Keerthibaalan/XY-Pen-Plotter/User, Technical and Design/Team23-PenPlotter_v5.xlsx

Sheet: User,Technical & Design Requri
Project Name |  | XY-Pen Plotter
Date |  | 2023-12-03
Version |  | 5-Final Version
Group Name |  | MERO Team 23
Group Members |  | Daniya Ahmed Mohamad Sahil Nazeer Keerthibaalan Thiruvalluvan Ram Charan Vuyyala Rathan Pradeep Kumar
UR # | Title | User Requirement | Remark | Domain (HW/SW/ME/all) | Must / Wish | TS # | ref. to UR # | Title | Technical Requirement | Remark | Domain (HW/SW/ME/all) | Must / Wish | DS # | ref. to TS # | Description | Reference (# bill of materials, article # supplier part, ref. doc # etc..) to implementation | Remark | Domain (HW, SW, ME, all)
Application |  |  |  |  |  | Application |  |  |  |  |  |  | Application
UR1 | Intended Use | The 2D pen plotter should be designed with the capability of creating a Nicolas House using a microcontroller. |  | all | Must | TS1 | UR1 UR2 | Intended Use | The 2D pen-plotter is speciafially designed for educational purpose, to be used by the MERO students, to draw a Nicolas house and understand the working of a Mechatronics system |  | all | Must | DS1 | TS1 TS2 TS3 TS4 | The 2D pen-plotter is aimed at education purpose; to be used only within the university, both by professors and students | Group23_PenPLotter_Project_Dossier |  | all
UR2 |  | It is intended to be used only for academic purpose by the University students to understand the synergy between different domains of a Mechatronic system. |  | all | Must | TS2 | UR3 UR4 | Focus Group | The plotter is designed with the intention to be used by both MERO students and faculties of all genders and of the age group 20-60 years |  | all | Must
UR3 | Focus Group | The main focus group for the device are the Master's students of Mechatronics and Robotics. |  | all | Must | TS3 | UR5 | Use case | The pen plotter is mainly developed to satisfy the purpose of drawing a Nicolas house, by controlling the motion of a pen in the X and Y directions |  | all | Must
UR4 |  | Anyone (male/female/others) between the age of 20 and 60 years should also be able to use it. |  | all | Must | TS4 | UR6 | Site of Application | The unit is developed with the intention of using it indoors, especially in a laboratory setting. It could also be used in homes, offices and other indoor environments |  | all | Must
UR5 | Use case | Drawing the Nicolas House in a linear motion by moving the pen plotter in the X and Y directions. |  | all | Must
UR6 | Site of Application | The plotter is mainly designed for indoor use, including but not limited to laboratory work inside university, homes and offices. |  | all | Must
General Functions |  |  |  |  |  | General Functions |  |  |  |  |  |  | General Functions
UR7 | Portability | It should be compact and light so that it can be easily managed and carried around. |  | all | Must | TS5 | UR7 | Dimensions | The whole plotter assembly should be able to fit in a box of dimension 56x39x42cm |  | all | Must | DS2 | TS5 | Overall dimension should be less than 305x305x420 mm | Base Plate; Bill of materials (doc.#(Group23_BOM)) |  | all
UR8 | Lifespan | The unit should work flawless at least for one semester. |  | all | Must | TS6 |  | Weight | The weight of the entire unit, including the frame and components should not exceed 3.5 kg |  | all | Must | DS3 |  |  | CAD Assembly Model (PenPlotter.sldasm) |  | all
UR9 | Precision | The plotter should be able to draw perfect straight lines with high accuracy and precision. |  | ME | Must | TS7 | UR8 | Lifespan | Th pen plotter should operate for atleast 100 cycles of Nicolas House or 60-70m of pen motion |  | all | Must | DS4 | TS6 | Overall weight of the unit should be less than 3.5kg | Bill of materials (doc.#(Group23_BOM)) |  | all
UR10 | Speed | It should be able to draw quickly and in a time efficient manner. |  | HW | Wish | TS8 | UR9 UR12 | Precision & Consistency | The lines drawn should be perfectly straight with an accuracy of 0.1mm and the offset between the lines should be less than 1mm |  | all | Must | DS5 |  |  | CAD Assembly Model (PenPlotter.sldasm) |  | all
UR11 | Durability | The build should be sturdy enough to withstand minor drops and shocks. |  | ME | Must | TS9 | UR10 | Speed | The Nicolas house should be drawn within 45 seconds (approximately 5 seconds per line) |  | HW | Wish | DS6 | TS7 | Total Life span should be either 100 cycles of the drawing or 60-70 m of pen motion | Bill of materials (doc.#(Group23_BOM)) |  | all
UR12 | Consistency | It should create the drawings consistently without any offsets in the lines drawn. |  | all | Must | TS10 | UR11 | Durability | The box holding the unit should be lined with shock absorber material, so that it can withstand mishandlings and drops from a height of 0.5m |  | ME | Must | DS7 | TS8 TS11 TS12 | Precise lines to be drawn without any offsets | Guide shafts, Timing Belt, Dampers; Bill of materials (doc.#(Group23_BOM)) |  | all
UR13 | Stability | The unit should create the drawing without much vibration. |  | ME | Must | TS11 | UR13 UR14 | Stability & Quiet Operation | The belts used for transmitting power should be elastic and able to restrict the lateral vibration |  | ME | Must | DS8 | TS9 TS28 | Total time taken for drawing should be less than a minute | Motors, Motor Drivers; Bill of materials (doc.#(Group23_BOM)) |  | HW
UR14 | Quiet operation | It should operate quietly without generating excessive noise. |  | ME | Wish | TS12 |  |  | Dampers are installed between the motor and the base plate, that absorbs vibrartions inturn leading to reduced noise. |  | ME | Must | DS9 | TS10 | Minor shocks due to mishandling or drops should be withstood | Shock absorber; Bill of materials (doc.#(Group23_BOM)) | Cost effective materials like 'Bubble wraps' could be used | ME
UR15 | Usability | It should be easy to setup and use, without the need for any special tools or skills. |  | all | Must | TS13 | UR15 UR16 | Ease of usage and maintenance | The plotter follows a modular design that enables easy assembly and disassembly of the components; this also makes the maintenance easy |  | HW & ME | Must | DS10 | TS13 | Modular design of the unit for easy assembly and maintenance | CAD Assembly Model (PenPlotter.sldasm) |  | ME & HW
UR16 | Maintenance | The assembly, disassembly and cleaning of the unit should be easy to do. |  | all | Must | TS14 | UR17 | Safety | The maximum volatge supply used should be less than 24V, so that no strict supervision of the users is needed |  | HW | Must | DS11 | TS14 | The supply voltage should not be greater than 24V | Power Supply Unit; Bill of materials (doc.#(Group23_BOM)), Technical datasheet. | Breadboard Power supply TS1171 is used | HW
UR17 | Safety | The plotter should be safe to use by anyone from the Focus group without any strict supervision. |  | all | Must | TS15 |  |  | The motors and the other electronic components should be covered with proper insulating materials |  | HW | Must | DS12 | TS15 TS34 | Proper insulation should be provided for the electrical and electronic components | PVC Pipes; Bill of materials (doc.#(Group23_BOM)) |  | HW
UR18 | Safety | There should be some safety provisions available to stop the plotter in case of an emergency. |  | HW & SW | Must | TS16 | UR18 | Safety | There should be a dedicated stop switch to stop the operation in case of emergency |  | HW | Wish | DS13 | TS16 | Provision for Emergency stop button | Red Push Button; Bill of materials (doc.#(Group23_BOM)) |  | HW
UR19 | Calibration | There should be a dedicated point on the plot area which is used for calibration. |  | ME | Must | TS17 | UR19 | Calibration | An explicit reference point should be defined to carry out the calibration process |  | SW | Must | DS14 |  |  | Microncontroller Program (PenPlotter_MainProgram.c) |  | SW
Module Function |  | Tool Gripper |  |  |  | Module Function |  |  | Tool Gripper |  |  |  | DS15 | TS17 | Explicit reference point for Calibration | Microncontroller Program (PenPlotter_MainProgram.c) |  | SW
UR20 | Size | The gripper should be compatible with different types and sizes of writing tools like pen, pencil, marker etc. |  | HW | Must | TS18 | UR20 | Pen Size | The gripper should be able to hold writing tools like pens, pencils etc. with maximum outer diameter of 15mm |  | HW | Must | Module Function |  | Tool Gripper
UR21 | Grip | It should be tight enough to hold the pen in the exact position throughout the trial. |  | HW | Must | TS19 | UR21 | Grip | The gripper should have provisions like loaded spring or screws that holds the writing tool firmly in a defined position and the pressure is evenly distributed |  | HW | Must | DS16 | TS18 | The gripper is designed for holding writing tools of various sizes | CAD Model (Gripper.sld) |  | HW & ME
UR22 | Easy installation | It should be easy to insert and remove writing the tools from the gripper |  | HW | Must | TS20 | UR22 | Easy installation | The gripper part should be 3D printed and detachable from the slider base, so that the writing tool can be easily fixed or removed. |  | HW | Must | DS17 | TS19 TS20 TS21 | The gripper assembly should hold the tool firmly and should be easy to maintain | CAD Assembly Model (ToolGripper.sldasm) |  | HW & ME
Module Function |  | Plotting Board + Frame |  |  |  | TS21 | UR30 | Flexibility | There should be enogh provision on the tool holder to put the tool gripper at any angle |  | ME | Must | Module Function |  | Plotting Board + Frame
UR23 | Size | The plotting board should have enough space to accommodate the pen-plotter and the paper. |  | HW & ME | Must | Module Function |  |  | Plotting Board + Fame |  |  |  | DS18 | TS22 TS23 TS24 | The Plotting Board should hold papers of different sizes and its surface should be properly polished | Wooden Baseplate; Bill of materials (doc.#(Group23_BOM)) |  | HW
UR24 | Paper | Should be able to accommodate different standard sizes and thickness of paper. |  | HW | Must | TS22 | UR23 | Size | The maximum size of the plotting board should not exceed the dimension 56x42cm, so that it can fit in the box |  | HW & ME | Must | DS19 | TS25 | The board is provided with clamps to hold the paper in place | Clamps/Clips; Bill of materials (doc.#(Group23_BOM)) |  | HW
UR25 | Surface | The plotting surface must be smooth enough to get legible drawings. |  | HW | Must | TS23 | UR24 | Paper | Paper of any size between 10x10cm and A4 size should be able to be accommodated |  | HW | Must | DS20 | TS26 | Mounts for necessary equipments should be 3D printed separately | CAD Model (Mounts.sld) | Separate CAD models for all the mounts needed. | ME
UR26 | Clamping | There should be provisions given for proper clamping of the paper. |  | HW & ME | Must | TS24 | UR25 | Surface & Thickness | Properly polished wooden board has to be used as the base plateand its thickness has to be selected in such a way that the total weight falls under the specified amount |  | HW | Must | DS21 | TS27 | Robber bushes on the bottom of the baseplate to prevent slipping | Rubber Bushes; Bill of materials (doc.#(Group23_BOM)) |  | HW
UR27 | Mounts | There should be separate mounts for the hardware components utilized. |  | ME | Must | TS25 | UR26 | Clamping | The board has to be included with mounting easel (board with clips) that can hold paper, cards and envelopes of various sizes |  | HW & ME | Must
UR28 | Anti-slip | Provisions should be available to prevent the base plate from slipping |  | ME | Wish | TS26 | UR27 | Mounts | The board should have provisions to hold the 3D printed mounts created for the individual components. |  | ME | Must
Module Function |  | Drive System |  |  |  | TS27 | UR28 | Anti-slip | The bottom side of the Plotting board should have rubber bushes to prevent it from slipping |  | ME | Wish
UR29 | Speed | It should be possible to move the gripper with various velocities. |  | ME | Must | Module Function |  |  | Drive System |  |  |  | Module Function |  | Drive System
UR30 | Flexibility | Drawing lines at any angle should be possible on the 2D plane. |  | ME | Must | TS28 | UR29 UR39 | Speed | The motors used should be controlled by appropriate motor drivers that is capable of operating the motors in variable speeds based on the program written. |  | ME | Must | DS22 | TS29 | Power from the motor should be transferred efficiently | Timing Belt; Bill of materials (doc.#(Group23_BOM)) |  | HW
UR31 | Efficiency | The power from the actuators (motors) should be transferred efficiently to the gripper without much loss. |  | ME & HW | Must | TS29 | UR31 | Efficiency | Need to use timing belts/ropes and pulley drives for efficient transfer of the motion or power from the motors to the slider. i.e., without any slippage |  | ME & HW | Must
UR32 | Feedback | It should be an open-loop drive system which does not require any feedback. |  | ME | Must | TS30 | UR32 | Feedback | The system should be simple, that is there is no need to use any sensors to obtain the feedback from the tool gripper |  | ME | Must
Module Function |  | Power Supply |  |  |  | Module Function |  |  | Power Supply |  |  |  | Module Function |  | Power Supply
UR33 | Power | The plotter unit should be powered via a USB port |  | HW | Must | TS31 | UR33 | Power | The supply voltage should range between 3.3 and 3.6V, and a minimum current of 500mA, supplied via a USB Type cable |  | HW | Must | DS23 | TS31 TS33 | The required power supply (500mA @ 3.3 - 3.6 V) should be supplied via a USB Type cable | Lithium Battery, Power Supply unit; Bill of materials (doc.#(Group23_BOM)), Technical datasheet | Breadboard Power supply TS1171 is used | HW
UR34 | Button | Push button should be used to turn on/off the unit. |  | HW | Must | TS32 | UR34 | Power button | Dedicated push button should be provided to turn the pen plotter on/off |  | HW | Must | DS24 | TS32 | A push button to turn the pen plotter on/off is provided | Green Push Button; Bill of materials (doc.#(Group23_BOM)) |  | HW
UR35 | Safety | Safety measures against current overloading and voltage fluctuations should be provided |  | HW | Must | TS33 | UR35 | Safety | The power supply is chosen such that any marginal overcurrent or voltage cannot damage the electronic components |  | HW | Must
Module Function |  | Connections |  |  |  | Module Function |  |  | Connections |  |  |  | Module Function |  | Connections
UR36 | Cables | Standard cables should be used to establish connections without any soldering. |  | HW | Must | TS34 | UR36 UR37 | Cables | CE certified Jumper cables should be used to establish the circuit connection. These cables should be standard, properly insulated and avoid the need for soldering. Cable guides should be used for cable routing |  | HW | Must | DS25 | TS34 | Standard cables should be used for power and data transfer | Jumper cables; Bill of materials (doc.#(Group23_BOM)) |  | HW
UR37 | Insulation | The wires should be properly insulated to avoid any hazards. |  | HW | Must
Module Function |  | Control Unit |  |  |  | Module Function |  |  | Control Unit |  |  |  | Module Function |  | Control Unit
UR38 | Microcontroller | Standard microcontroller should be used to control the overall working of the plotter. |  | HW | Must | TS35 | UR38 | Microcontroller | A Standard microcontroller should be used to control the entire unit. |  | HW | Must | DS26 | TS35 TS37 | Standard Microcontroller should be used and all the electronic components should have a common ground | ESP32 Microcontroller, Jumper cables; Bill of materials (doc.#(Group23_BOM)) |  | HW
UR39 | Drivers | There should be drivers to control the actuators and ensure their smooth functioning. |  | HW | Must | TS36 | UR40 | Sensors/switches | Limit switches or Position sensors need to be used to determine the end positions |  | HW | Must | DS27 | TS36 | The end positions of the gripper should identified using Limit switches / sensors | Hall effect sensor, Limit Switches; Bill of materials (doc.#(Group23_BOM)) |  | HW
UR40 | Sensors/Switches | The plotter should be able to detect home and end positions. |  | HW | Must | TS37 | UR41 | Grounding | The electronic components used should be properly grounded to the microcontroller ground to eliminate noises |  | HW | Must
UR41 | Grounding | All Electronics should be properly grounded to avoid unnecessary noises. |  | HW | Must
Module Function |  | Software |  |  |  | Module Function |  |  | Software |  |  |  | Module Function |  | Software
UR42 | HMI | An interface should be available to control the plotter via smartphone using Bluetooth or Wi-Fi. |  | SW | Must | TS38 | UR42 | HMI | A Human Machine Interface needs to be developed that provides a communication between a smartphone and the controller of the plotter via Wi-Fi. |  | SW | Must | DS28 | TS38 TS41 TS42 TS43 | A C program should be written that is capable of carrying out all the required pen plotter tasks | Microncontroller Program (PenPlotter_MainProgram.c) | Separate functions corresponding to the individual tasks should be created | SW
UR43 | Workstation | The program/data file should be feeded via any device compatible with the microcontroller |  | SW | Must | TS39 | UR43 | Workstation | Any laptop either with windows or mac OS with an internet access and an USB port, should be able to code the microcontroller used. |  | SW | Must | DS29 | TS40 | An Integrated Development Environment for developing C programs and loading them into the microcontroller has to be used | Reference to the Arduino IDE |  | SW
UR44 | IDE | An open source IDE should be used to write, execute and load the codes into the microcontroller. |  | SW | Must | TS40 | UR44 | IDE | The Arduino IDE should be used to write and load the code into the ESP32 microcontroller. C language should be used for programming |  | SW | Must
UR45 | Code structure | The code should be easily readable and understandable. |  | SW | Must | TS41 | UR45 | Code structure | While writing the code, standard headers files should be used, proper naming conventions for variables have to be followed, necessary comments should be added and appropriate indentations should be used. |  | SW | Must
UR46 | Messages | The user interface should show appropriate messages based on the current action or error. |  | SW | Wish | TS42 | UR46 | Messages | The program should include functions to display appropriate messages like 'Drawing in Progress', 'Error Occured', 'Process Completed' |  | SW | Wish
UR47 | Customization | The unit should be capable of creating drawings other than Nikolaus House. |  | SW | Wish | TS43 | UR47 | Customization | A logic capable of converting any desired drawings into corresponding codes should be integrated as part of the main program |  | SW | Wish
Commercial Requirements |  |  |  |  |  | Commercial Requirement |  |  |  |  |  |  | Commercial Requirement
UR48 | Date of Completion | The plotter should be completely built and be ready for the presentation before the date of exam |  | all | Must | TS44 | UR48 | Date of Completion | The plotter along with the entire Hardware and software components should be completed and be ready for submission before November 2023 |  | all | Must | DS30 | TS45 | The Total cost incurred for developing the Pen Plotter should not exceed 100 Euros | Bill of materials (doc.#(Group23_BOM)) |  | all
UR49 | Cost | The plotter should be economical and the total cost of the unit should not exceed 100 Euros |  | all | Wish | TS45 | UR49 | Cost | The majority of the components used shall be 3D printed using ABS (Acrylonitrile Butadiene Styrene) to keep the cost down |  | all | Wish | DS31 |  |  | CAD Assembly Model (PenPlotter.sldasm) |  | all
Regulations and Standards |  |  |  |  |  | Regulations and Standards |  |  |  |  |  |  | Regulations and Standards
UR50 | Conformity to standards | The parts and components used should be compliant with the corresponding standards. |  | all | Must | TS46 | UR50 UR51 | Conformity to Standards | All the hardware components used should follow the DIN/ISO standards and the electrical/electronic components should follow the IEC/IEEE and RoHS standards |  | all | Must | DS32 | TS46 TS47 | The supplier parts and designed model should follow conformity to their corresponding standards | Reference to documents related to standards like DIN, ISO, IEC and so on |  | all
UR51 | Quality Standards | The plotter should adhere to industrial quality standards | Since it is only for academic purpose, no need to follow the DKE standardization policies | all | Must | TS47 | UR51 | Quality Standard | The parts 3D printed in the University Laboratory must be standardized and fit into requirements |  | all | Must

Sheet: Verification and Validation
Verification Protocol |  |  |  |  | Verification Report |  |  |  |  |  |  | Validation Protocol |  |  |  |  |  |  |  | Validation Report
VerP # | ref to TS # | test procedure (description of routine) | verification criterion | Domain (HW/SW/ME/all) | VerR # | ref. to VerP # | Test function (to be copied from verification protocol) | nominal criterion, the target value | actual value | criterion passed/failed | Domain (HW/S/W/ME/ all) | ValP # | ref. to UR # | Module | Domain (HW/SW/ME/all) | test function to be verified (can be copied from TS or described in own words) | Test setup / Procedure | target / nominal criteria, value | criteria passed / failed | ValR # | ref. to ValP # | criteria Passed/Failed
Application |  |  |  |  | Application |  |  |  |  |  |  | Application |  |  |  |  |  |  |  | Application
VerP1 | TS3 | Set up pen plotter, Start pen plotter and draw Nikolaus' House. | The home should have angular and linear lines. | ALL | VerR1 | VerP1 | Set up pen plotter, Start pen plotter and draw Nikolaus' House. | The home should have angular and linear lines. | The house has the angular and linear lines. | Passed | ALL | ValP1 | UR5 | General | ALL | Drawing the Nicolas House in a linear motion by moving the pen plotter in the X and Y directions. | Check the movments are correct in X and Y directions | The house has the angular and linear lines | Passed | ValR1 | ValP1 | Passed
General Functions |  |  |  |  | General Functions |  |  |  |  |  |  | General Functions |  |  |  |  |  |  |  | General Functions
VerP2 | TS6 | The weight of assembly should be less than 3.5 kg.(Measure with the help of weighing machine) | The assembly should weigh no more than 3.5 kg. | HW | VerR2 | VerP2 | The weight of assembly should be less than 3.5 kg.(Measure with the help of weighing machine) | weight < 3.5 kg | Weight is less than 3.5 kg | Passed | HW | ValP2 | UR7 | General | HW | Weight of the entire pen plotter assembly should be around 3.5kg. | The weight is measured using weighing machine | Weight is less than 3.5 kg | Passed | ValR2 | ValP2 | Passed
VerP3 | TS5,TS6 | Put pen plotter in box, carried out by focus group, easy top handle | The pen plotter should be easy to handle | HW | VerR3 | VerP3 | Put pen plotter in box, carried out by focus group, easy top handle | Easy handling of pen plotter | Students can handle pen plotter easily | Passed | HW | ValP3 | UR2 | General | HW | University Students, Age of 24 to 30 Years, Male/Female should use this pen plotter | University students should be able to use this pen plotter | Students should handle pen plotter easily | Passed | ValR3 | ValP3 | Passed
Module Function – Mechanical |  |  |  |  | Module Function – Mechanical |  |  |  |  |  |  | Module Function – Mechanics |  |  |  |  |  |  |  | Module Function – Mechanics
VerP4 | TS18 | The gripper should be able to hold writing tools like pens, pencils etc. with maximum outer diameter of 15mm | The gripper should hold a pen/pencil of max outer diameter of 15mm | ME | VerR4 | VerP4 | The gripper should be able to hold writing tools like pens, pencils etc. with maximum outer diameter of 15mm | Control with a Screw | Tightness and dia controlled with a screw mechanism | Passed | ME | ValP4 | UR20 | General | ME | The gripper should be compatible with different types and sizes of writing tools like pen, pencil, marker etc. | Check the rigidity of the Pen | Tightness and dia controlled with a screw mechanism | Passed | ValR4 | ValP4 | Passed
VerP5 | TS25,TS26,TS27 | To check whether the 3D printed parts are assembled properly and the movement of bearings, rods, belt and pulley is smooth. | The belt and pulley must run smoothly | ME | VerR5 | VerP5 | To check whether the 3D printed parts are assembled properly and the movement of bearings, rods, belt and pulley is smooth. | Smooth movement of mechanical parts | Mechanical parts are working smoothly | Passed | ME | ValP5 | UR26,UR27 | General | ME | All the mechanical parts such as bearings, rod , pulley, belt should operate smoothly. Minimum friction between the componenets | Measuring noise and vibrations of the components, smooth operation of pen plotter can be confirmed | The mechanical parts should work without friction | Passed | ValR5 | ValP5 | Passed
Module Function - Software |  |  |  |  | Module Function - Software |  |  |  |  |  |  | Module Function - Software |  |  |  |  |  |  |  | Module Function - Software
VerP6 | TS40 | Programming the ESP32 in the Arduino IDE and uploading the programme in ESP32. | The check code is written in the "Arduino IDE" program and uploaded in ESP-32 | SW | VerR6 | VerP6 | Programming the ESP32 in the Arduino IDE and uploading the programme in ESP32. | To check whether program is uploaded or not through LED on Microcontroller | Program is uploaded successfully | Passed | SW | ValP6 | UR44 | General | SW | An open-source software called Arduino IDE was used to program the control function of the pen-plotter. | By running the pen plotter, one can confirm that pen plotter is working according to logic | To check whether program is uploaded or not check thr LED on the Microcontroller | Passed | ValR6 | ValP6 | Passed
Regulatory and Standards |  |  |  |  | Regulatory and Standards |  |  |  |  |  |  | Regulatory and Standards |  |  |  |  |  |  |  | Regulatory and Standards
VerP7 | TS46 | The device must be developed in accordance with the IEC/IEEE and RoHS standards | To follow rules and regulations of IEC/IEEE and RoHS standards | ALL | VerR7 | VerP7 | The device must be developed in accordance with the IEC/IEEE and RoHS standards | To follow rules and regulations of IEC/IEEE and RoHS standards | Rules and regulations of IEC/IEEE and RoHS standards are followed. | Passed | ALL | ValP7 | UR50 | General | ALL | The device must be developed in accordance with the IEC/IEEE and RoHS standards | Refer to the regulations of IEC/IEEE and RoHS standards | To follow rules and regulations in IEC/IEEE and RoHS standards. | Passed | ValR7 | ValP7 | Passed
Module Motor Controller Electronics & Wiring |  |  |  |  | Module Motor Controller Electronics & Wiring |  |  |  |  |  |  | Module Motor Controller Electronics & Wiring |  |  |  |  |  |  |  | Module Motor Controller Electronics & Wiring
VerP8 | TS33 | The device power should be cut off when the emergency push button is pressed. | Standard CE Emergency push button (power on & off) is used to cut off the power supply. To check power cut off when push button is pressed | HW | VerR8 | VerP8 | The device power should be cut off when the emergency push button is pressed. | Power is cut off and pen plotter stopped working. | "3" (Normally Closed) | Passed | HW | ValP8 | UR18 | General | HW | Standard CE Emergency push button (power on & off) is used to cut off the power supply. | After pushing the emergency button, pen plotter should stop working | Power is cut off and pen plotter stopped working. | Passed | ValR8 | ValP8 | Passed
VerP9 | TS31,TS32,TS33,TS34 | Turn on power source and electrical circuits as well as Connect controller with laptop using USB cable | To make sure that power is on and all the devices are connected | HW | VerR9 | VerP9 | Turn on power source and electrical circuits as well as Connect controller with laptop using USB cable | To check LED on circuit and notifications in laptop for connections | Electric circuits and controller connected successfully | Passed | HW | ValP9 | UR33,UR34,UR35,UR36 | General | HW | Turn on power source and electrical circuits as well as Connect controller with laptop using USB cable | To check LED on circuit and notifications in laptop for connections | To check LED on circuit and notifications in laptop for connections | Passed | ValR9 | ValP9 | Passed
Vep10 | TS36 | Functionality of Limit switch | After pressing the limit switch, the pen plotter should stop working | HW | VerR10 | VerP10 | Functionality of Limit switch | After pressing the limit switch, the pen plotter should stop working | Pen plotter stopped working | Passed | HW | ValP10 | UR40 | General | HW | Pen plotter should stop after pressing limit switch | After pressing the limit switch, pen plotter should stop working | After pressing the pen plotter should stop working | Passed | ValR10 | ValP10 | Passed
